bowmanlab/pier_sampler_code/CAD_files/syringe mount.SLDPRT

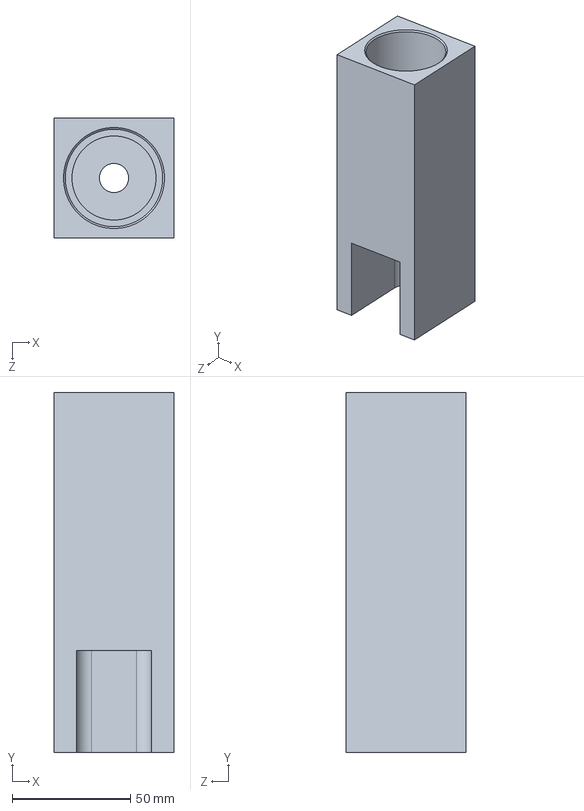
[picture p2: CAD file, 2017-06-12]
CAD_files/syringe mount.SLDPRT
50.8 x 152.4 x 50.8 mm
