bowmanlab/pier_sampler_code/CAD_files/plunger.SLDPRT

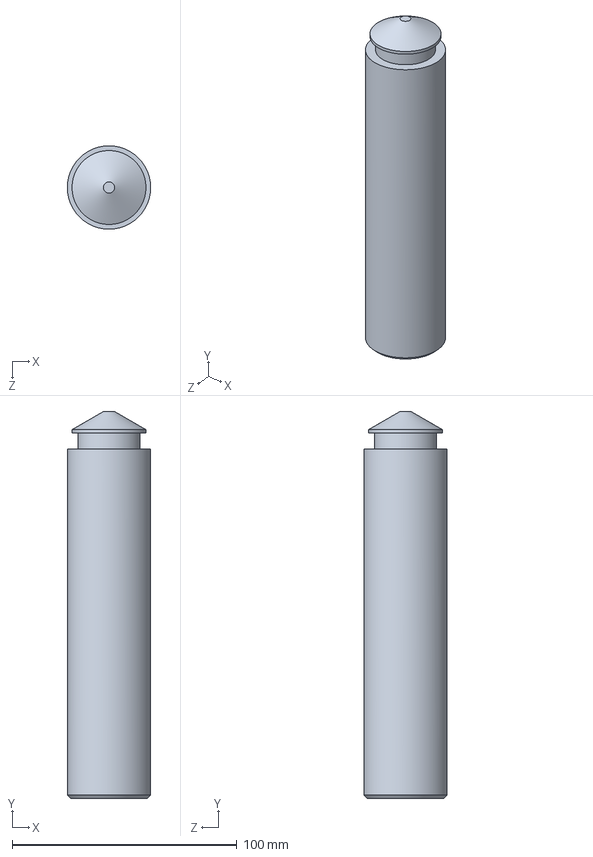
[picture p3: CAD file, 2017-06-12]
CAD_files/plunger.SLDPRT
37.1 x 172.2 x 37.1 mm
