bowmanlab/pier_sampler_code/CAD_files/Bowman manifold.SLDPRT

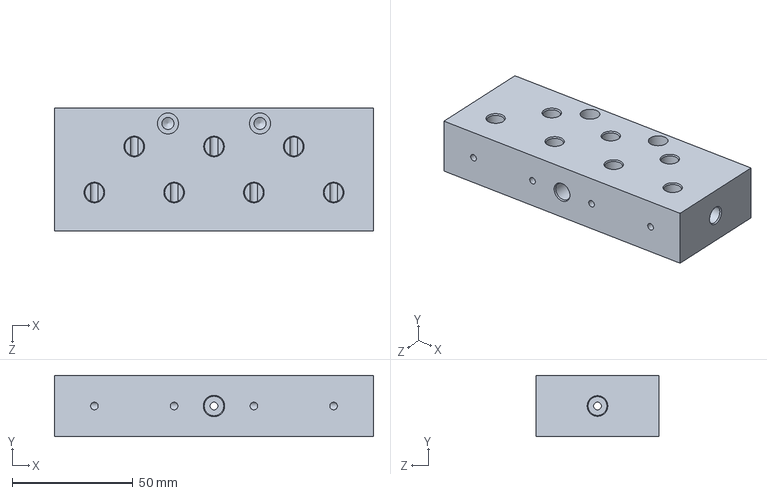
[picture p4: CAD file, 2017-06-12]
CAD_files/Bowman manifold.SLDPRT
132.1 x 25.4 x 50.8 mm
