bowmanlab/pier_sampler_code/(list of files, cad)

Other CAD files:
CAD_files/Bowman manifold.x_t
CAD_files/plunger.x_t
CAD_files/syringe mount.x_t
