bowmanlab/pier_sampler_code/board/SCRIPPS_new_board_.brd

## EAGLE design board/SCRIPPS_new_board_.brd (2018-01-30)

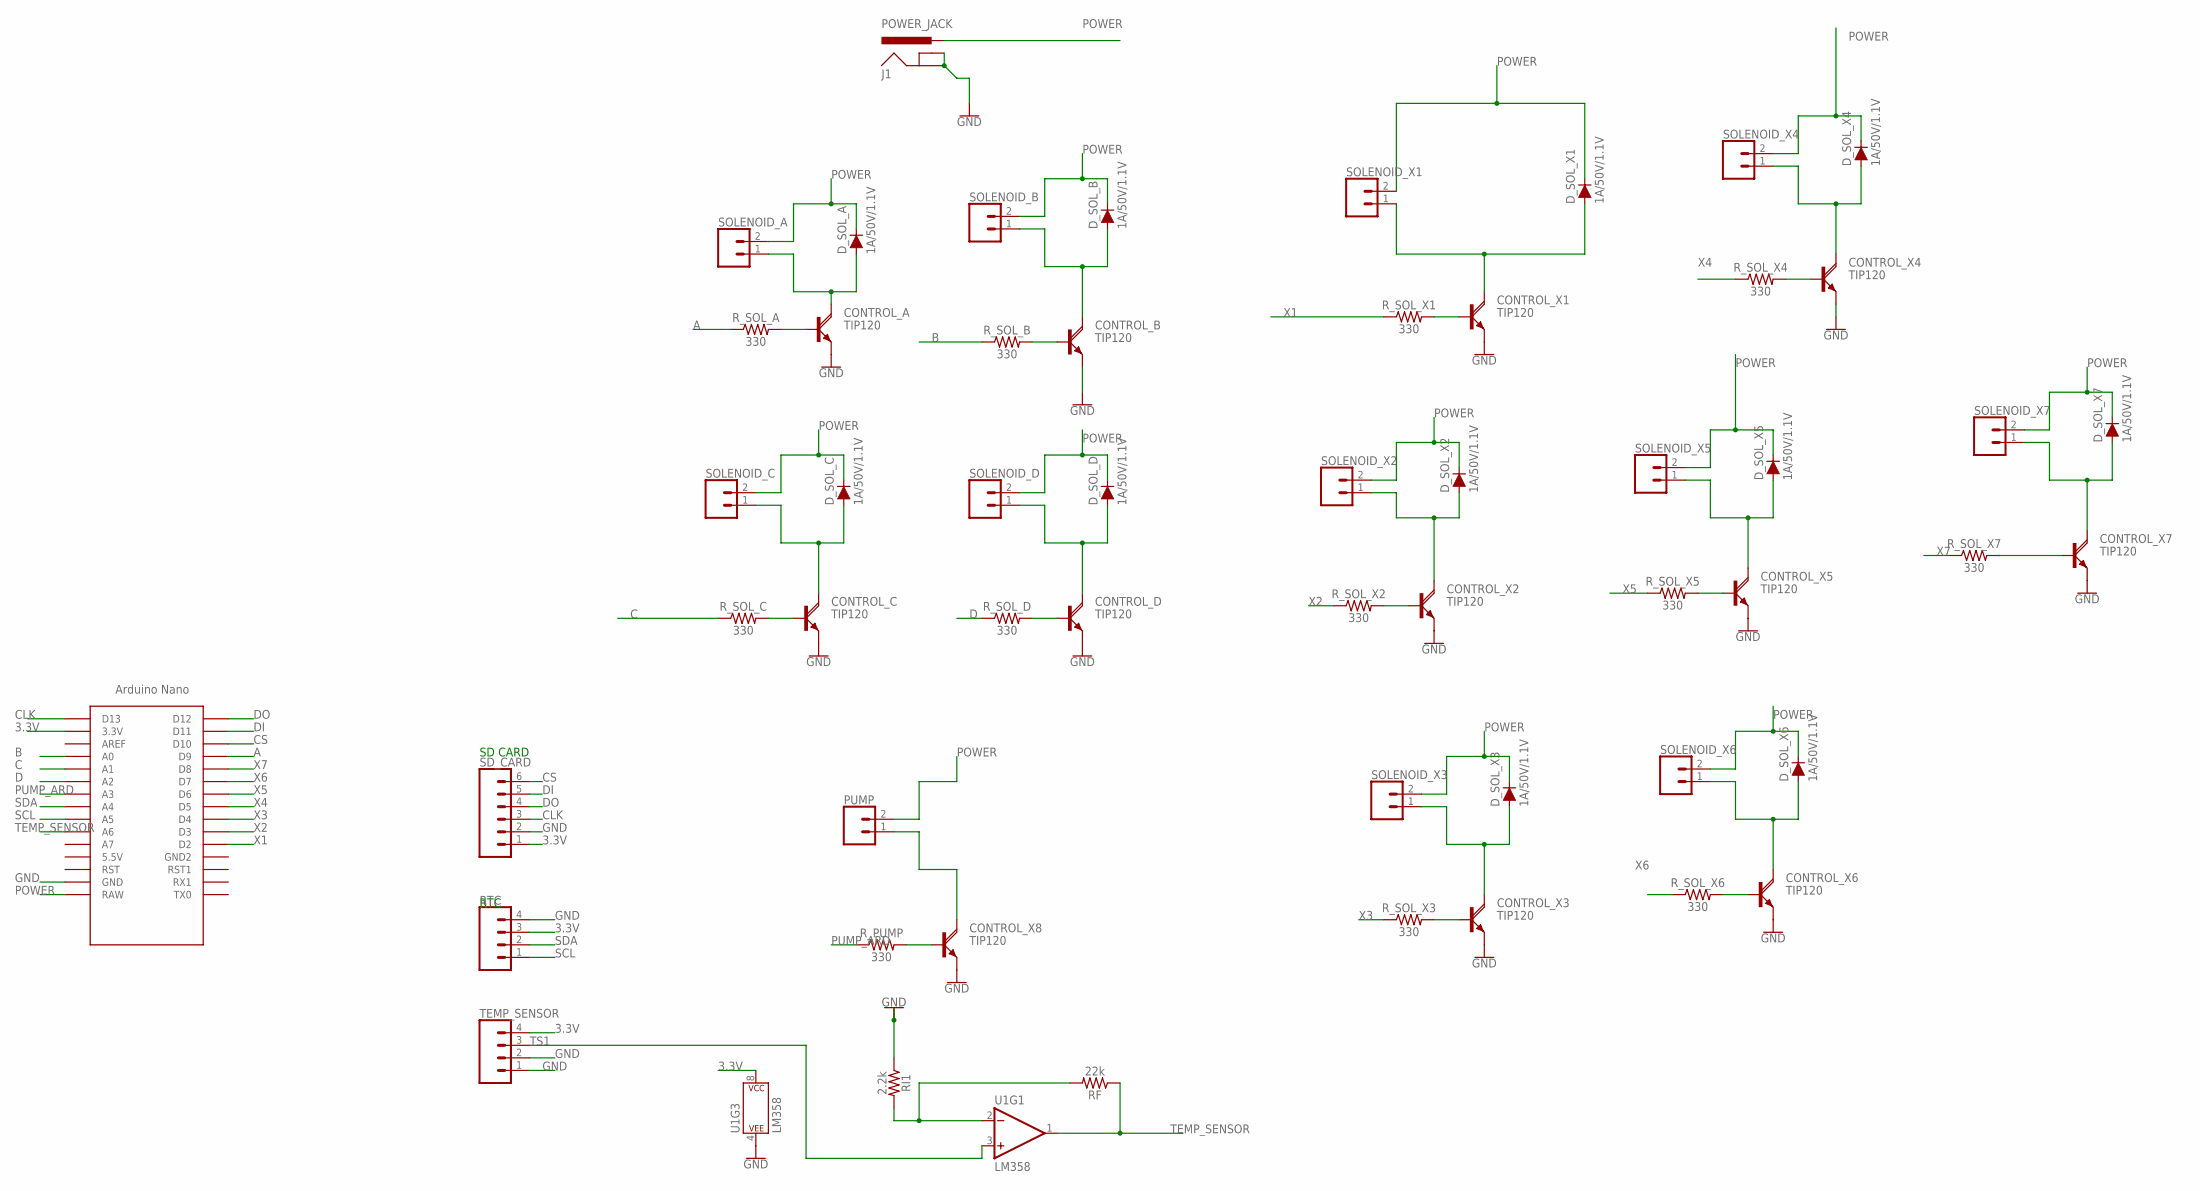
[picture p5: schematic SCRIPPS_new_board_.sch]

Parts:
CONTROL_A: TIP120; TO220AH
CONTROL_B: TIP120; TO220AH
CONTROL_C: TIP120; TO220AH
CONTROL_D: TIP120; TO220AH
CONTROL_X1, CONTROL_X2, CONTROL_X3, CONTROL_X4, CONTROL_X5, CONTROL_X6, CONTROL_X7, CONTROL_X8: TIP120; TO220AH
D_SOL_A: 1A/50V/1.1V; DIODE-1N4001
D_SOL_B: 1A/50V/1.1V; DIODE-1N4001
D_SOL_C: 1A/50V/1.1V; DIODE-1N4001
D_SOL_D: 1A/50V/1.1V; DIODE-1N4001
D_SOL_X1, D_SOL_X2, D_SOL_X3, D_SOL_X4, D_SOL_X5, D_SOL_X6, D_SOL_X7: 1A/50V/1.1V; DIODE-1N4001
J1: POWER_JACK; POWER_JACK_PTH
PUMP: CONN_02; 1X02
RF: 22k; AXIAL-0.3
RI1: 2.2k; AXIAL-0.3
RTC: CONN_04; 1X04
R_PUMP: 330; AXIAL-0.3
R_SOL_A: 330; AXIAL-0.3
R_SOL_B: 330; AXIAL-0.3
R_SOL_C: 330; AXIAL-0.3
R_SOL_D: 330; AXIAL-0.3
R_SOL_X1, R_SOL_X2, R_SOL_X3, R_SOL_X4, R_SOL_X5, R_SOL_X6, R_SOL_X7: 330; AXIAL-0.3
SD_CARD: CONN_06FEMALE_LOCK; 1X06_FEMALE_LOCK.010
SOLENOID_A: CONN_02; 1X02
SOLENOID_B: CONN_02; 1X02
SOLENOID_C: CONN_02; 1X02
SOLENOID_D: CONN_02; 1X02
SOLENOID_X1, SOLENOID_X2, SOLENOID_X3, SOLENOID_X4, SOLENOID_X5, SOLENOID_X6, SOLENOID_X7: CONN_02; 1X02
TEMP_SENSOR: CONN_04; 1X04
U1: LM358; DIP08
U$2: NANO

Connections:
3.3V: RTC.3, SD_CARD.1, TEMP_SENSOR.4, U1.8 (P$V+), U$2.3.3V
A: R_SOL_A.P$1 (1), U$2.D9
B: R_SOL_B.P$1 (1), U$2.A0
C: R_SOL_C.P$1 (1), U$2.A1
CLK: SD_CARD.3, U$2.D13
CS: SD_CARD.6, U$2.D10
D: R_SOL_D.P$1 (1), U$2.A2
DI: SD_CARD.5, U$2.D11
DO: SD_CARD.4, U$2.D12
unnamed: CONTROL_X8.B, R_PUMP.P$2 (2)
unnamed: CONTROL_X8.C, PUMP.1
unnamed: CONTROL_X1.C, D_SOL_X1.A, SOLENOID_X1.1
unnamed: CONTROL_X1.B, R_SOL_X1.P$2 (2)
unnamed: CONTROL_C.B, R_SOL_C.P$2 (2)
unnamed: CONTROL_A.B, R_SOL_A.P$2 (2)
unnamed: CONTROL_A.C, D_SOL_A.A, SOLENOID_A.1
unnamed: CONTROL_C.C, D_SOL_C.A, SOLENOID_C.1
unnamed: RF.P$2 (2), RI1.P$2 (2), U1.2 (-IN)
unnamed: CONTROL_B.B, R_SOL_B.P$2 (2)
unnamed: CONTROL_B.C, D_SOL_B.A, SOLENOID_B.1
unnamed: CONTROL_D.B, R_SOL_D.P$2 (2)
unnamed: CONTROL_D.C, D_SOL_D.A, SOLENOID_D.1
unnamed: CONTROL_X5.B, R_SOL_X5.P$2 (2)
unnamed: CONTROL_X2.C, D_SOL_X2.A, SOLENOID_X2.1
unnamed: CONTROL_X7.B, R_SOL_X7.P$2 (2)
unnamed: CONTROL_X7.C, D_SOL_X7.A, SOLENOID_X7.1
unnamed: CONTROL_X5.C, D_SOL_X5.A, SOLENOID_X5.1
unnamed: CONTROL_X4.B, R_SOL_X4.P$2 (2)
unnamed: CONTROL_X4.C, D_SOL_X4.A, SOLENOID_X4.1
unnamed: CONTROL_X2.B, R_SOL_X2.P$2 (2)
unnamed: CONTROL_X3.B, R_SOL_X3.P$2 (2)
unnamed: CONTROL_X3.C, D_SOL_X3.A, SOLENOID_X3.1
unnamed: CONTROL_X6.B, R_SOL_X6.P$2 (2)
unnamed: CONTROL_X6.C, D_SOL_X6.A, SOLENOID_X6.1
POWER: D_SOL_A.C, D_SOL_B.C, D_SOL_C.C, D_SOL_D.C, D_SOL_X1.C, D_SOL_X2.C, D_SOL_X3.C, D_SOL_X4.C, D_SOL_X5.C, D_SOL_X6.C, D_SOL_X7.C, J1.PWR, PUMP.2, SOLENOID_A.2, SOLENOID_B.2, SOLENOID_C.2, SOLENOID_D.2, SOLENOID_X1.2, SOLENOID_X2.2, SOLENOID_X3.2, SOLENOID_X4.2, SOLENOID_X5.2, SOLENOID_X6.2, SOLENOID_X7.2, U$2.RAW
PUMP_ARD: R_PUMP.P$1 (1), U$2.A3
SCL: RTC.1, U$2.A5
SDA: RTC.2, U$2.A4
TEMP_SENSOR: RF.P$1 (1), U1.1 (OUT), U$2.A6
TS1: TEMP_SENSOR.3, U1.3 (+IN)
X1: R_SOL_X1.P$1 (1), U$2.D2
X2: R_SOL_X2.P$1 (1), U$2.D3
X3: R_SOL_X3.P$1 (1), U$2.D4
X4: R_SOL_X4.P$1 (1), U$2.D5
X5: R_SOL_X5.P$1 (1), U$2.D6
X6: R_SOL_X6.P$1 (1), U$2.D7
X7: R_SOL_X7.P$1 (1), U$2.D8

Notes on the sheet:
SD CARD
RTC

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
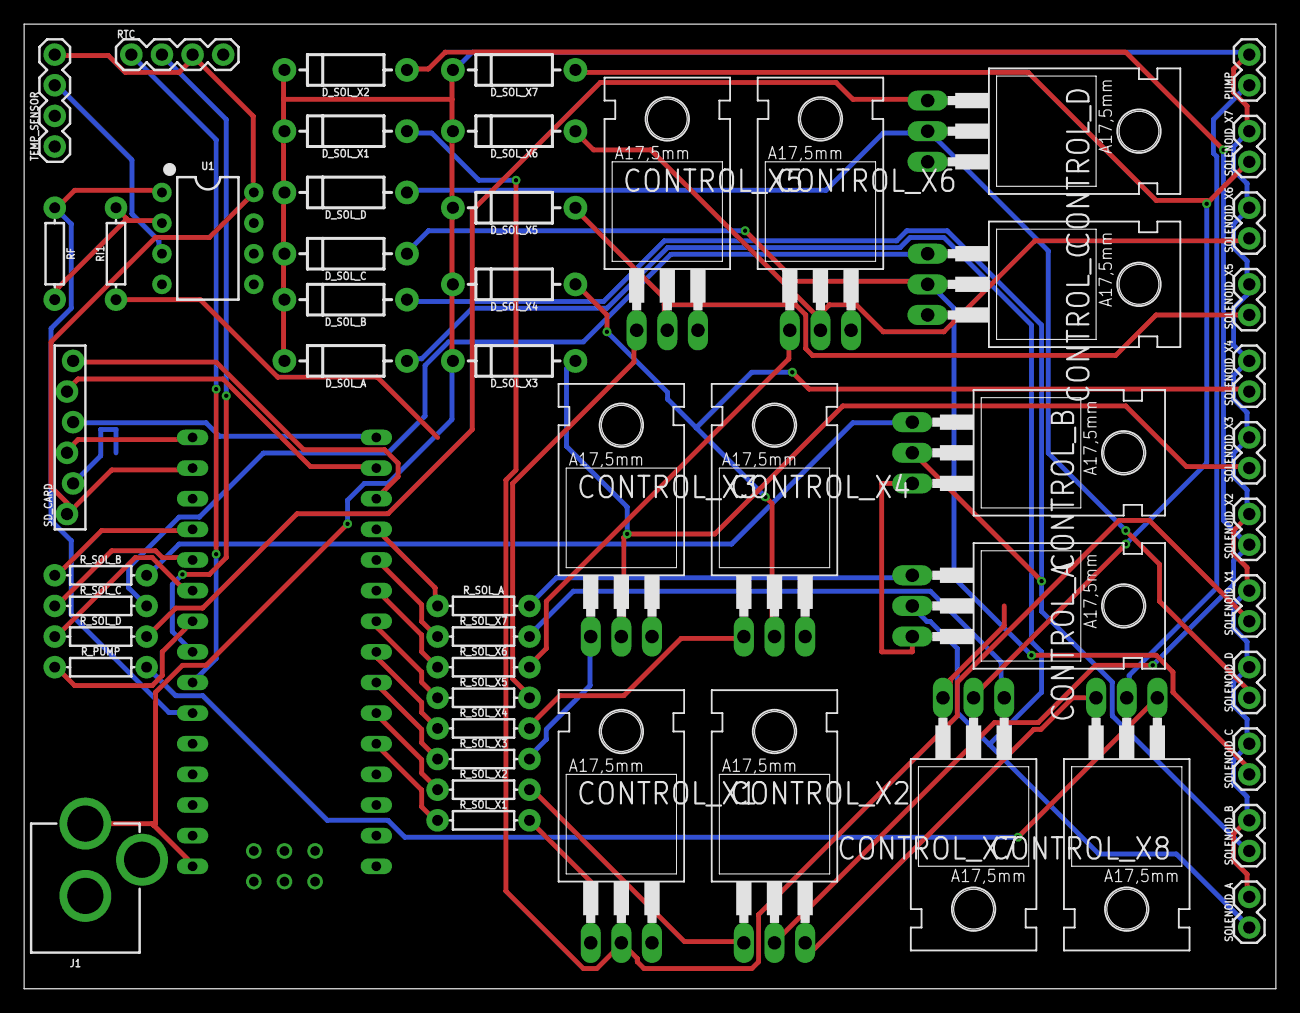
[picture p6: board SCRIPPS_new_board_.brd from above]

Board: 2 copper layers, 103.8 x 80.0 mm, 55 parts (0 on the bottom side), 48 nets.
