bowmanlab/pier_sampler_code/(commit log)

2017-06-12 add CAD files
    [Bowman manifold.SLDPRT, Bowman manifold.x_t, plunger.SLDPRT, plunger.x_t, syringe mount.SLDPRT, syringe mount.x_t]
2018-01-30 new board and code
    [SCRIPPS_new_board_.brd, SCRIPPS_new_board_.sch]
